fsegurac/design_emb/FPGA.png

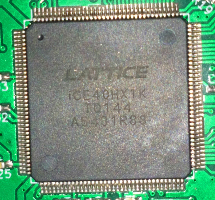
FPGA.png
