fsegurac/design_emb/STM.png

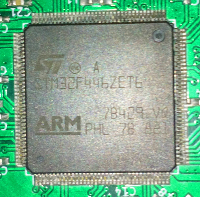
STM.png
