fsegurac/design_emb/stm32f446ze/README.txt

##Herramientas necesarias:

sudo apt-get install gcc-arm-none-eabi
sudo apt-get install libnewlib-arm-none-eabi

NOTA: los archivos principales fueron generados con ayuda del software STM32CubeMx
