fsegurac/design_emb/links.txt

MANUAL KICAD: http://docs.kicad-pcb.org/4.0.7/es/getting_started_in_kicad.html
STM32F446ZE: https://www.st.com/en/microcontrollers/stm32f446ze.html#samplebuy-scroll
SR3.3.TCT: https://www.semtech.com/uploads/documents/sr3.3.pdf
SR2.8.TCT: https://co.mouser.com/datasheet/2/761/sr2_8-1277654.pdf
V. REGULATOR: https://www.digikey.com/products/en/integrated-circuits-ics/pmic-voltage-regulators-linear/699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
https://www.digikey.com/product-detail/en/texas-instruments/TLV1117LV33DCYR/296-28778-2-ND/2666508

COMANDOS GIT:
git init
git add README.md
git commit -m "comentario"
git remote add origin https://github.com/fsegurac/design_emb.git
git push -u origin master
