fsegurac/design_emb/Arachne.png

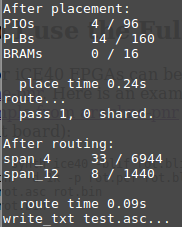
Arachne.png
