fsegurac/design_emb/Board.png

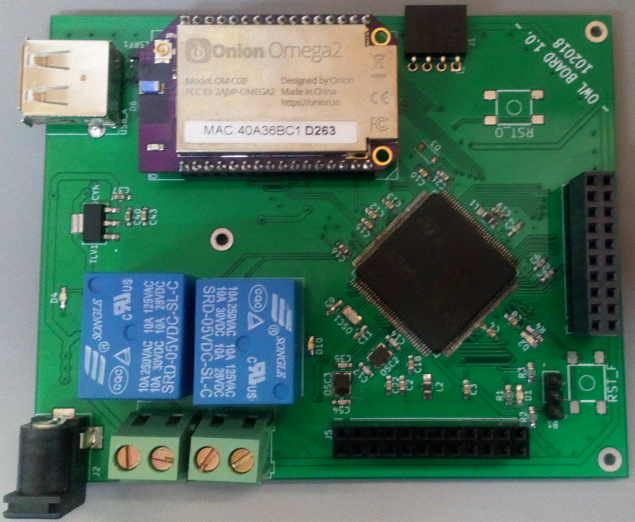
Board.png
