fsegurac/design_emb/JTAGcnfig1.png

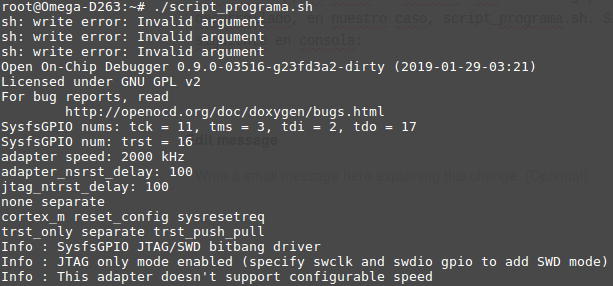
JTAGcnfig1.png
