fsegurac/design_emb/JTAGcnfig2.png

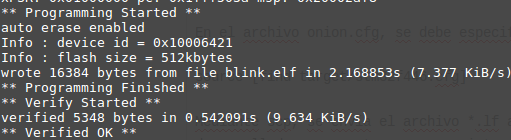
JTAGcnfig2.png
