fsegurac/design_emb/JTAGpins.png

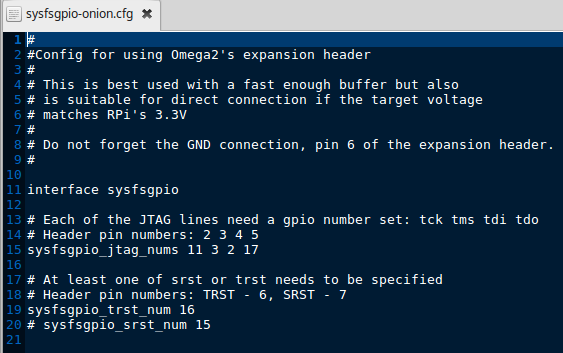
JTAGpins.png
