fsegurac/design_emb/onion/D263.png

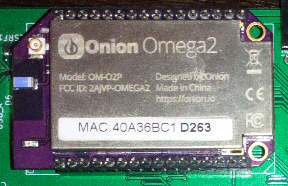
onion/D263.png
