fsegurac/design_emb/onion/OmegaDone.png

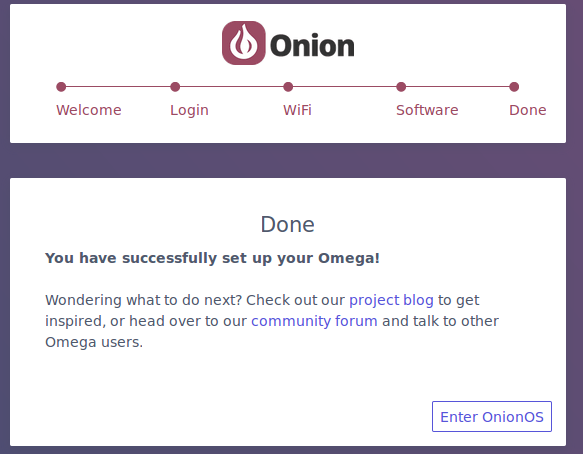
onion/OmegaDone.png
