fsegurac/design_emb/onion/OnionLogin.png

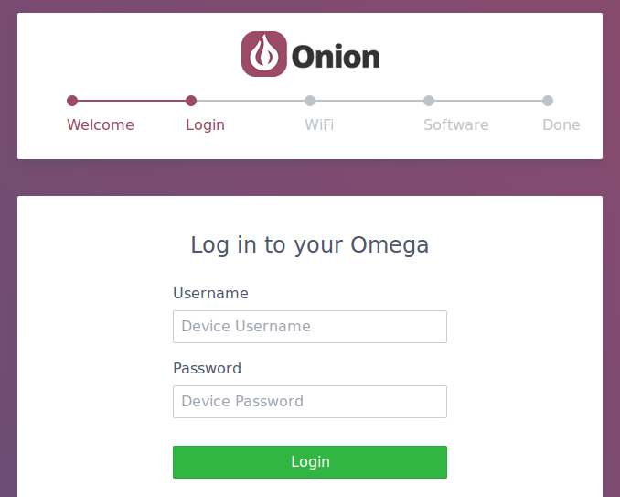
onion/OnionLogin.png
