fsegurac/design_emb/onion/OnionMenu.png

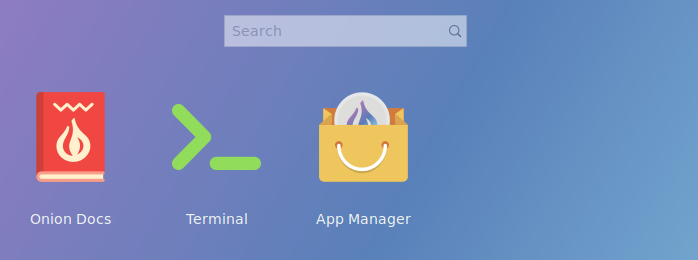
onion/OnionMenu.png
