fsegurac/design_emb/onion/OnionSSH.png

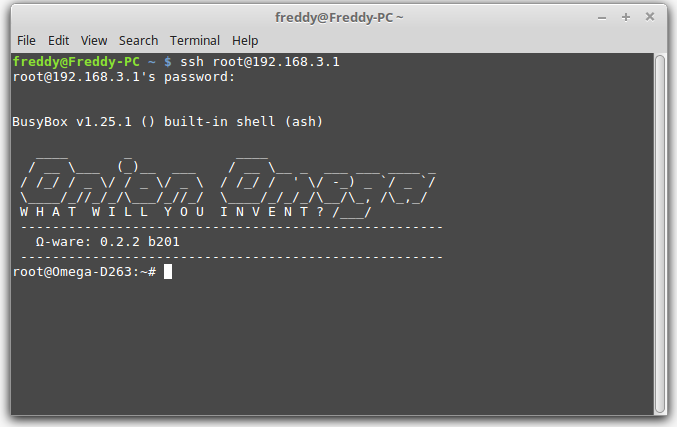
onion/OnionSSH.png
