fsegurac/design_emb/onion/OnionToUpdate.png

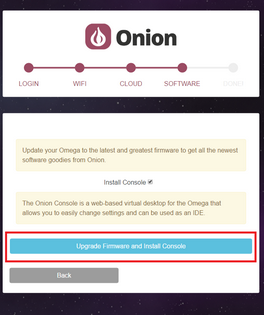
onion/OnionToUpdate.png
