fsegurac/design_emb/onion/WirelessNetwork.png

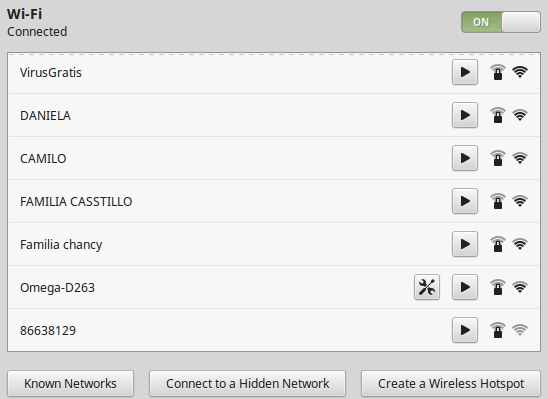
onion/WirelessNetwork.png
