fsegurac/design_emb/(list of files, cad)

Other CAD files:
kicad/modules/kicad-footprints-master/Sources/Package_SON/X2SON-4_1x1mm_P0.65mm.fcstd
kicad/modules/kicad-footprints-master/Sources/Package_TO_SOT_THT/sod-70_P5.08mm.fcstd
kicad/modules/kicad-footprints-master/Sources/Package_TO_SOT_THT/sod-70.fcstd
