fsegurac/design_emb/(list of files, drawings)

Other design files:
kicad/design_emb.dsn
