fsegurac/design_emb/kicad/design_emb.kicad_pcb

## KiCad design kicad/design_emb.kicad_pcb (2019-03-18)

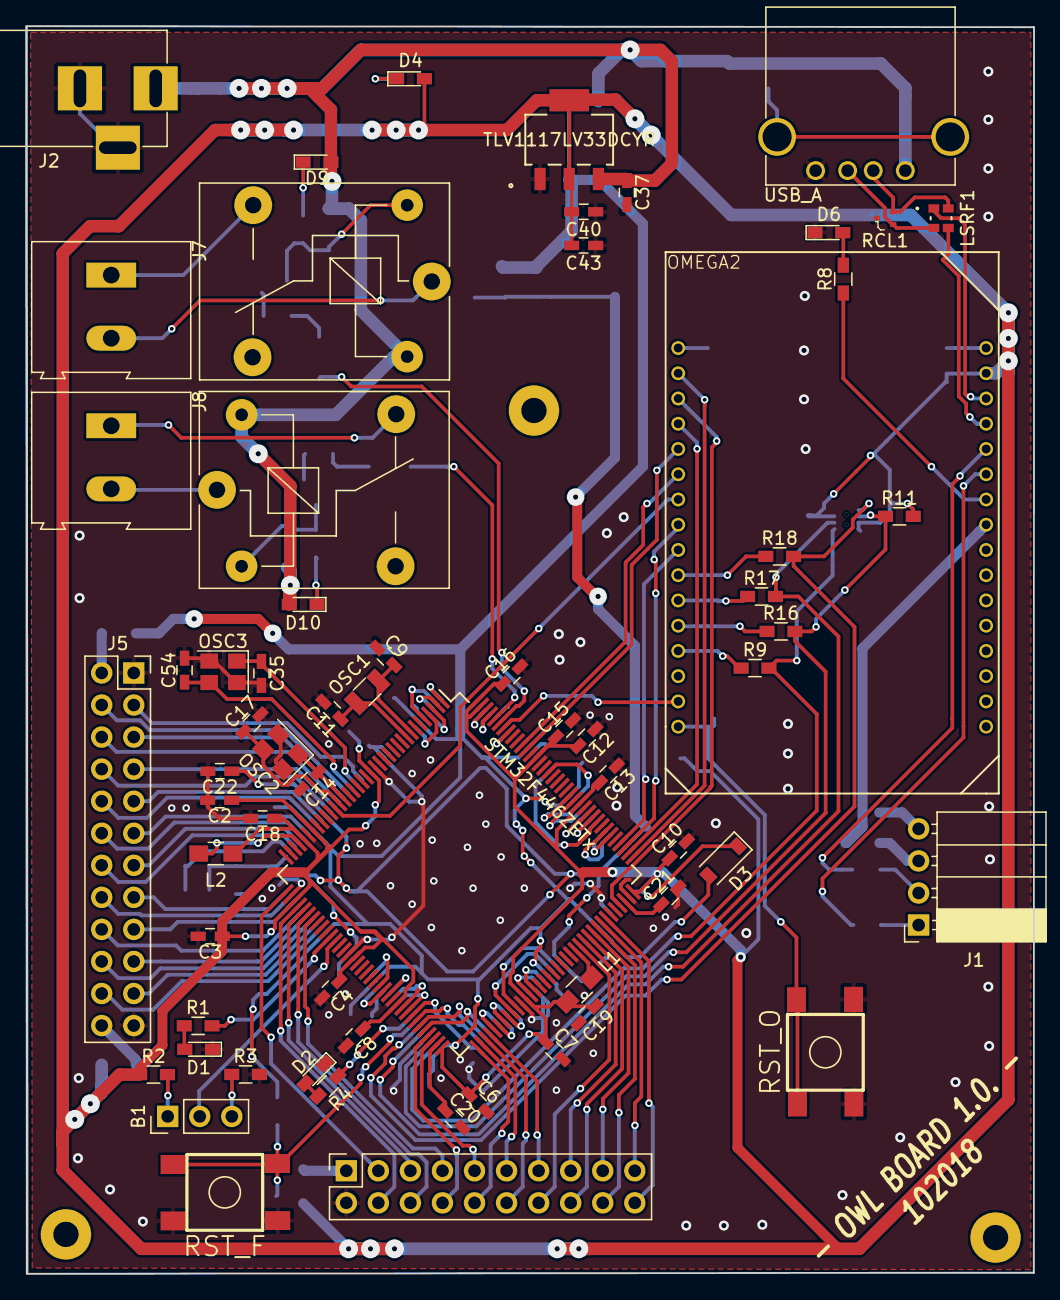
[picture p15: board design_emb.kicad_pcb from above]

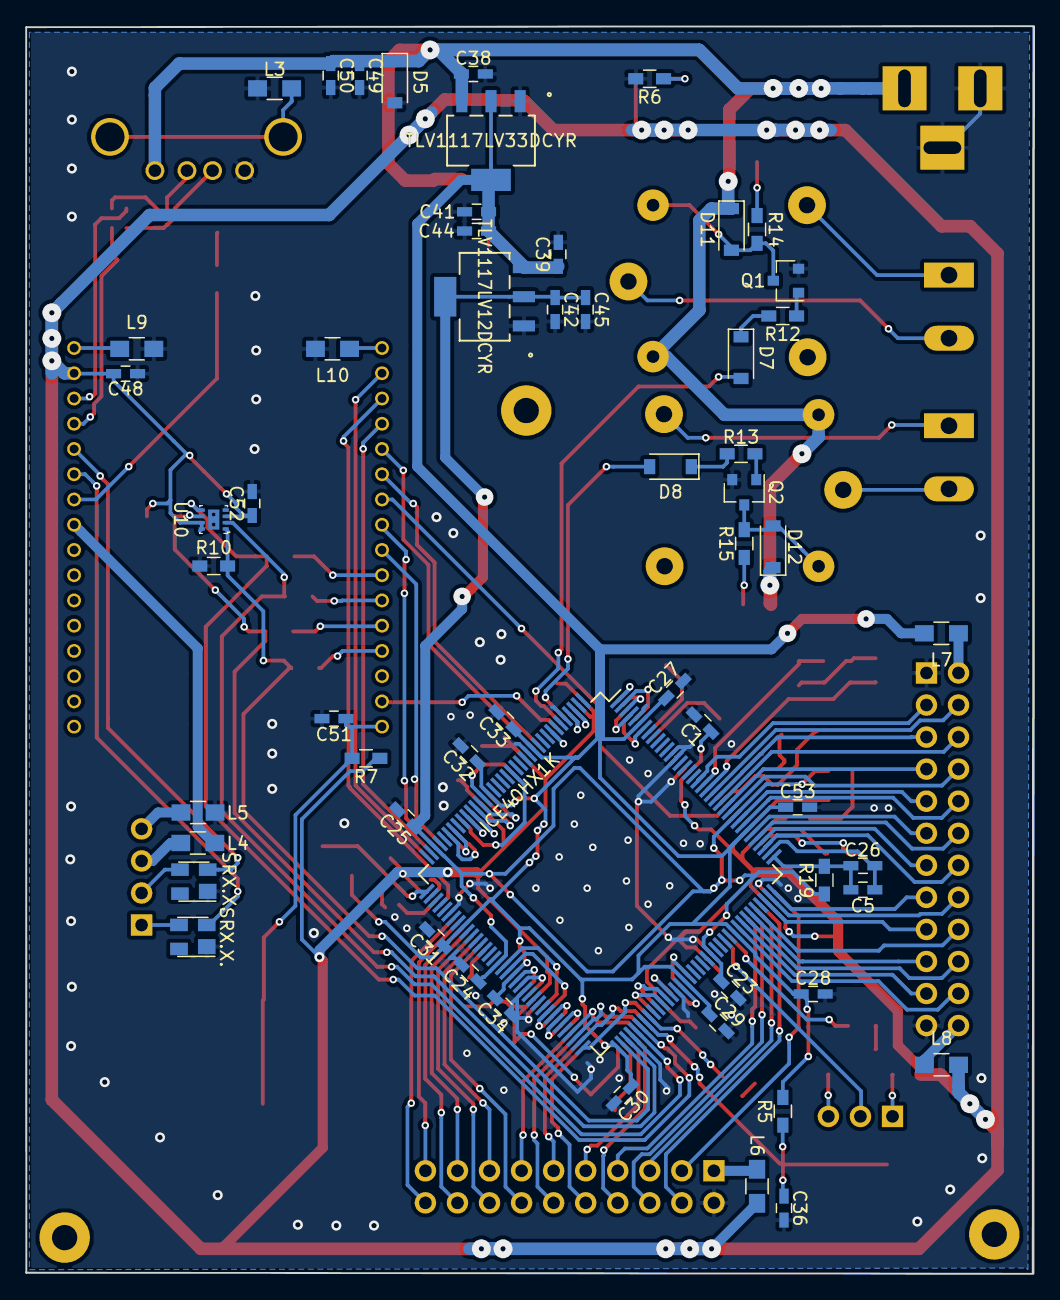
[picture p16: board design_emb.kicad_pcb from below]

Board: 2 copper layers, 79.8 x 98.9 mm, 121 parts (56 on the bottom side), 149 nets.

Parts:
B1: Conn_01x03; Pin_Header_Straight_1x03_Pitch2.54mm
C1, C2, C3, C4, C6, C7, C8, C10, C12, C13, C15, C18, C22, C23, C24, C25, C26, C27, C28, C29, C30, C31, C32, C33, C34, C36, C48, C51, C52, C53: 100nF; C_0603_HandSoldering
C5: 10uF; C_0603_HandSoldering
C9, C11: 9pF; C_0603_HandSoldering
C14, C17, C35, C54: 10pF; C_0603_HandSoldering
C16: 4.7uF; C_0603_HandSoldering
C19, C37, C38, C39, C40, C41, C42: 1uF; C_0603_HandSoldering
C20, C21: 2.2uF; C_0603_HandSoldering
C43, C44, C45, C50: 0.1uF; C_0603_HandSoldering
C49: 33uF; C_0603_HandSoldering
D1: LED_PRB; LED_0603_HandSoldering
D2: LED; LED_0603_HandSoldering
D3: 1N5817; D_SOD-123
D4: LED_ON; LED_0603_HandSoldering
D5: D_Scho; D_SOD-123
D6: LED_PROBE; LED_0603_HandSoldering
D7, D8: D_Schottky; D_SOD-123
D9, D10: LED_REL_ON; LED_0603_HandSoldering
D11, D12: D; D_SOD-123
ICE40HX1K: ICE40HX1K; LQFP-144_20x20mm_Pitch0.5mm
J1: Conn_01x04; PinSocket_1x04_P2.54mm_Horizontal
J2: Barrel_Jack; BARREL_JACK
J5: Conn_02x12_Counter_Clockwise; Socket_Strip_Straight_2x12_Pitch2.54mm
J6: Conn_02x10_Counter_Clockwise; Socket_Strip_Straight_2x10_Pitch2.54mm
J7, J8: Screw_Terminal_01x02; TerminalBlock_Altech_AK300-2_P5.00mm
K1, K2: SANYOU_SRD_Form_C; Relay_SPDT_SANYOU_SRD_Series_Form_C
L1, L2: INDUCTOR; L_0805_HandSoldering
L3, L4, L5, L6, L7, L8, L9, L10: L; L_0805_HandSoldering
LSRF1: SRF2012-900YA
OMEGA2: OMEGA2; ONION2
OSC1: 32,768K; Crystal_SMD_3215-2Pin_3.2x1.5mm
OSC2, OSC3: 12MHz; Crystal_SMD_Abracon_ABM8G-4pin_3.2x2.5mm
Q1, Q2: MMBT3904; SOT-23
R1, R4, R6, R8: 1k; R_0603_HandSoldering
R2, R3, R5, R7: 10k; R_0603_HandSoldering
R9, R16, R17, R18, R19: 100; R_0603_HandSoldering
R10, R11: 4.7k; R_0603_HandSoldering
R12, R13: 5,1K; R_0603_HandSoldering
R14, R15: 2,2K; R_0603_HandSoldering
RCL1: RCLAMP0502B; SOT-523
RST_F: SW_Push; TACTILE_SWITCH_6mm
RST_O: SW_Push; TACTILE_SWITCH_6mm
SRX.X., SRX.X.#2: SRX.X.TCT; SOT-143
STM32F446ZETx: STM32F446ZETx; LQFP-144_20x20mm_Pitch0.5mm
U5, U6: TLV1117LV33DCYR
U7: TLV1117LV12DCYR; TLV1117LV33DCYR
U10: S25FL116KOXNFIQ-11; WSON-8_2x2mm
USB_A: USB_A

Connections:
+5VA: C37.1, C38.1, C49.1, C50.1, D5.1, D9.2, D10.2, D11.1, D12.1, J2.1, K1.5, K2.5, U5.3, U6.3, USB_A.1
/3V3_O: L4.2, OMEGA2.25
/RX_OUT: J1.1, SRX.X..3
/SERIAL_RX: OMEGA2.27, SRX.X..2
/SERIAL_TX: OMEGA2.28, SRX.X.#2.2
/Sheet1/BOOT0: OMEGA2.15, STM32F446ZETx.138
/Sheet1/BOOT1: B1.2, STM32F446ZETx.48
/Sheet1/CTRL0: ICE40HX1K.137, STM32F446ZETx.137
/Sheet1/CTRL1: ICE40HX1K.128, STM32F446ZETx.117
/Sheet1/CTRL2: ICE40HX1K.118, STM32F446ZETx.118
/Sheet1/CTRL3: ICE40HX1K.119, STM32F446ZETx.119
/Sheet1/CTRL4: ICE40HX1K.120, STM32F446ZETx.122
/Sheet1/CTRL5: ICE40HX1K.121, STM32F446ZETx.123
/Sheet1/FMCA16: ICE40HX1K.81, STM32F446ZETx.80
/Sheet1/FMCA17: ICE40HX1K.90, STM32F446ZETx.81
/Sheet1/FMCA18: ICE40HX1K.91, STM32F446ZETx.82
/Sheet1/FMCA19: ICE40HX1K.3, STM32F446ZETx.2
/Sheet1/FMCA20: ICE40HX1K.4, STM32F446ZETx.3
/Sheet1/FMCA21: ICE40HX1K.7, STM32F446ZETx.4
/Sheet1/FMCA22: ICE40HX1K.2, STM32F446ZETx.5
/Sheet1/FMCA23: ICE40HX1K.1, STM32F446ZETx.1
/Sheet1/FMCA24: ICE40HX1K.122, STM32F446ZETx.128
/Sheet1/FMCAD0: ICE40HX1K.87, STM32F446ZETx.85
/Sheet1/FMCAD1: ICE40HX1K.88, STM32F446ZETx.86
/Sheet1/FMCAD2: ICE40HX1K.115, STM32F446ZETx.114
/Sheet1/FMCAD3: ICE40HX1K.114, STM32F446ZETx.115
/Sheet1/FMCAD4: ICE40HX1K.56, STM32F446ZETx.58
/Sheet1/FMCAD5: ICE40HX1K.58, STM32F446ZETx.59
/Sheet1/FMCAD6: ICE40HX1K.60, STM32F446ZETx.60
/Sheet1/FMCAD7: ICE40HX1K.61, STM32F446ZETx.63
/Sheet1/FMCAD8: ICE40HX1K.62, STM32F446ZETx.64
/Sheet1/FMCAD9: ICE40HX1K.73, STM32F446ZETx.65
/Sheet1/FMCAD10: ICE40HX1K.74, STM32F446ZETx.66
/Sheet1/FMCAD11: ICE40HX1K.75, STM32F446ZETx.67
/Sheet1/FMCAD12: ICE40HX1K.76, STM32F446ZETx.68
/Sheet1/FMCAD13: ICE40HX1K.78, STM32F446ZETx.77
/Sheet1/FMCAD14: ICE40HX1K.79, STM32F446ZETx.78
/Sheet1/FMCAD15: ICE40HX1K.80, STM32F446ZETx.79
/Sheet1/FMCNBL0: ICE40HX1K.141, STM32F446ZETx.141
/Sheet1/FMCNBL1: ICE40HX1K.142, STM32F446ZETx.142
/Sheet1/JTAG0: OMEGA2.2, STM32F446ZETx.109
/Sheet1/JTAG1: OMEGA2.3, STM32F446ZETx.105
/Sheet1/JTAG2: OMEGA2.4, STM32F446ZETx.110
/Sheet1/JTAG3: OMEGA2.5, STM32F446ZETx.133
/Sheet1/JTAG4: OMEGA2.6, STM32F446ZETx.134
/Sheet1/OSC32_IN: C9.1, OSC1.1, STM32F446ZETx.8
/Sheet1/OSC32_OUT: C11.1, OSC1.2, STM32F446ZETx.9
/Sheet1/OSC_IN: C14.1, OSC2.1, STM32F446ZETx.23
/Sheet1/OSC_OUT: C17.1, OSC2.3, STM32F446ZETx.24
/Sheet1/PROBE: R1.2, STM32F446ZETx.47
/Sheet1/UART4_RX: OMEGA2.9, STM32F446ZETx.112
/Sheet1/UART4_TX: OMEGA2.8, STM32F446ZETx.111
/Sheet1/USR1: J6.3, STM32F446ZETx.37
/Sheet1/USR2: J6.4, STM32F446ZETx.40
/Sheet1/USR3: J6.5, STM32F446ZETx.41
/Sheet1/USR4: J6.6, STM32F446ZETx.42
/Sheet1/USR5: J6.7, STM32F446ZETx.43
/Sheet1/USR6: J6.8, STM32F446ZETx.69
/Sheet1/USR7: J6.9, STM32F446ZETx.70
/Sheet1/USR8: J6.10, STM32F446ZETx.73
/Sheet1/USR9: J6.11, STM32F446ZETx.74
/Sheet1/USR10: J6.12, STM32F446ZETx.75
/Sheet1/USR11: J6.13, STM32F446ZETx.76
/Sheet1/USR12: J6.14, STM32F446ZETx.96
/Sheet1/USR13: J6.15, STM32F446ZETx.97
/Sheet1/USR14: J6.16, STM32F446ZETx.98
/Sheet1/USR15: J6.17, STM32F446ZETx.99
/Sheet1/USR16: J6.18, STM32F446ZETx.100
/Sheet1/USR17: J6.19, STM32F446ZETx.101
/Sheet1/USR18: J6.20, STM32F446ZETx.102
/Sheet1/VCAP1: C20.1, STM32F446ZETx.71
/Sheet1/VCAP2: C21.1, STM32F446ZETx.106
/Sheet1/VDDA: L2.2, STM32F446ZETx.33
/Sheet1/VDDUSB: L1.2, STM32F446ZETx.95
/Sheet2/JNRST: OMEGA2.7, STM32F446ZETx.25
/Sheet2/PROBE: OMEGA2.26, R8.1
/Sheet2/RESET: C51.1, OMEGA2.16, R7.2, RST_O.1
/Sheet2/SPI0: ICE40HX1K.71, R9.2, R10.2, U10.1
/Sheet2/SPI1: ICE40HX1K.70, R11.1, R16.2, U10.6
/Sheet2/SPI2: ICE40HX1K.68, R17.2, U10.2
/Sheet2/SPI3: ICE40HX1K.67, R18.2, U10.5
/Sheet2/USB+: LSRF1.1, OMEGA2.30
/Sheet2/USB-: LSRF1.3, OMEGA2.29
/Sheet4/+1V2_FPGA: C22.1, C23.1, C24.1, C25.1, C42.1, C45.1, ICE40HX1K.27, ICE40HX1K.51, ICE40HX1K.92, ICE40HX1K.111, R19.2, U7.2, U7.4
/Sheet4/+3V3: C1.1, C2.1, C3.1, C4.1, C6.1, C7.1, C8.1, C10.1, C12.1, C13.1, C15.1, C16.1, C18.1, C19.1, C40.1, C43.1, C48.1, C52.1, D4.2, L1.1, L2.1, L6.2, L8.2, OMEGA2.31, R2.1, R7.1, R11.2, STM32F446ZETx.17, STM32F446ZETx.30, STM32F446ZETx.32, STM32F446ZETx.39, STM32F446ZETx.52, STM32F446ZETx.62, STM32F446ZETx.72, STM32F446ZETx.84, STM32F446ZETx.108, STM32F446ZETx.121, STM32F446ZETx.131, STM32F446ZETx.143, STM32F446ZETx.144, U5.2, U5.4, U10.3, U10.7, U10.8
/Sheet4/+3V3_FPGA: C27.1, C28.1, C29.1, C30.1, C31.1, C32.1, C33.1, C34.1, C39.1, C41.1, C44.1, C53.1, D3.2, ICE40HX1K.6, ICE40HX1K.30, ICE40HX1K.46, ICE40HX1K.57, ICE40HX1K.72, ICE40HX1K.89, ICE40HX1K.100, ICE40HX1K.123, ICE40HX1K.133, L7.2, R5.2, U6.2, U6.4, U7.3
/Sheet5/IN_REL1: D7.2, STM32F446ZETx.139
/Sheet5/IN_REL2: D8.2, STM32F446ZETx.140
/TX_IN: J1.2, SRX.X.#2.3
/sheet3/CRESET_B: C36.1, ICE40HX1K.66, R5.1, RST_F.1
/sheet3/GPIO0: ICE40HX1K.19, J5.3
/sheet3/GPIO1: ICE40HX1K.22, J5.4
/sheet3/GPIO2: ICE40HX1K.23, J5.5
/sheet3/GPIO3: ICE40HX1K.24, J5.6
/sheet3/GPIO4: ICE40HX1K.25, J5.7
/sheet3/GPIO5: ICE40HX1K.26, J5.8
/sheet3/GPIO6: ICE40HX1K.28, J5.9
/sheet3/GPIO7: ICE40HX1K.29, J5.10
/sheet3/GPIO8: ICE40HX1K.31, J5.11
/sheet3/GPIO9: ICE40HX1K.32, J5.12
/sheet3/GPIO10: ICE40HX1K.33, J5.13
/sheet3/GPIO11: ICE40HX1K.34, J5.14
/sheet3/GPIO12: ICE40HX1K.37, J5.15
/sheet3/GPIO13: ICE40HX1K.38, J5.16
/sheet3/GPIO14: ICE40HX1K.39, J5.17
/sheet3/GPIO15: ICE40HX1K.41, J5.18
/sheet3/GPIO16: ICE40HX1K.42, J5.19
/sheet3/GPIO17: ICE40HX1K.43, J5.20
/sheet3/GPIO18: ICE40HX1K.44, J5.21
/sheet3/GPIO19: ICE40HX1K.45, J5.22
/sheet3/OSC_IN: C35.1, ICE40HX1K.20, OSC3.1
/sheet3/OSC_OUT: C54.1, ICE40HX1K.21, OSC3.3
/sheet3/PLLGND: C5.2, C26.2, ICE40HX1K.35
/sheet3/VCCPLL: C5.1, C26.1, ICE40HX1K.36, R19.1
GND: C1.2, C2.2, C3.2, C4.2, C6.2, C7.2, C8.2, C9.2, C10.2, C11.2, C12.2, C13.2, C14.2, C15.2, C16.2, C17.2, C18.2, C19.2, C20.2, C21.2, C22.2, C23.2, C24.2, C25.2, C27.2, C28.2, C29.2, C30.2, C31.2, C32.2, C33.2, C34.2, C35.2, C36.2, C37.2, C38.2, C39.2, C40.2, C41.2, C42.2, C43.2, C44.2, C45.2, C48.2, C49.2, C50.2, C51.2, C52.2, C53.2, C54.2, D1.1, D2.1, D5.2, D6.1, ICE40HX1K.5, ICE40HX1K.13, ICE40HX1K.14, ICE40HX1K.59, ICE40HX1K.69, ICE40HX1K.86, ICE40HX1K.103, ICE40HX1K.132, ICE40HX1K.140, J2.2, J2.3, J5.1, J5.23, J6.2, L3.2, L5.2, L9.2, L10.2, OSC2.2, OSC2.4, OSC3.2, OSC3.4, Q1.2, Q2.2, R3.2, R6.2, R10.1, RCL1.3, RST_F.2, RST_O.2, SRX.X..1, SRX.X.#2.1, STM32F446ZETx.16, STM32F446ZETx.31, STM32F446ZETx.38, STM32F446ZETx.51, STM32F446ZETx.61, STM32F446ZETx.83, STM32F446ZETx.94, STM32F446ZETx.107, STM32F446ZETx.120, STM32F446ZETx.130, U5.1, U6.1, U7.1, U10.4, USB_A.4
unnamed: D1.2, R1.1
unnamed: D2.2, R4.2
unnamed: D3.1, ICE40HX1K.108
unnamed: D4.1, R6.1
unnamed: D6.2, R8.2
unnamed: D7.1, R12.2
unnamed: D8.1, R13.2
unnamed: D9.1, R14.1
unnamed: D10.1, R15.1
unnamed: D11.2, K1.2, Q1.3, R14.2
unnamed: D12.2, K2.2, Q2.3, R15.2
unnamed: J1.3, L4.1
unnamed: J1.4, L5.1
unnamed: LSRF1.4, RCL1.2, USB_A.2
unnamed: LSRF1.2, RCL1.1, USB_A.3
unnamed: L3.1, USB_A.5
unnamed: B1.1, R2.2
unnamed: B1.3, R3.1
unnamed: J5.2, L7.1
unnamed: J5.24, L8.1
unnamed: J6.1, L6.1
unnamed: J7.1, K1.3
unnamed: J7.2, K1.1
unnamed: J8.1, K2.4
unnamed: J8.2, K2.1
unnamed: L9.1, OMEGA2.32
unnamed: L10.1, OMEGA2.1
unnamed: OMEGA2.10, R18.1
unnamed: OMEGA2.11, R17.1
unnamed: OMEGA2.12, R16.1
unnamed: OMEGA2.13, R9.1
unnamed: Q1.1, R12.1
unnamed: Q2.1, R13.1
unnamed: ICE40HX1K.65, R4.1
