fsegurac/design_emb/onion/OnionSetup.png

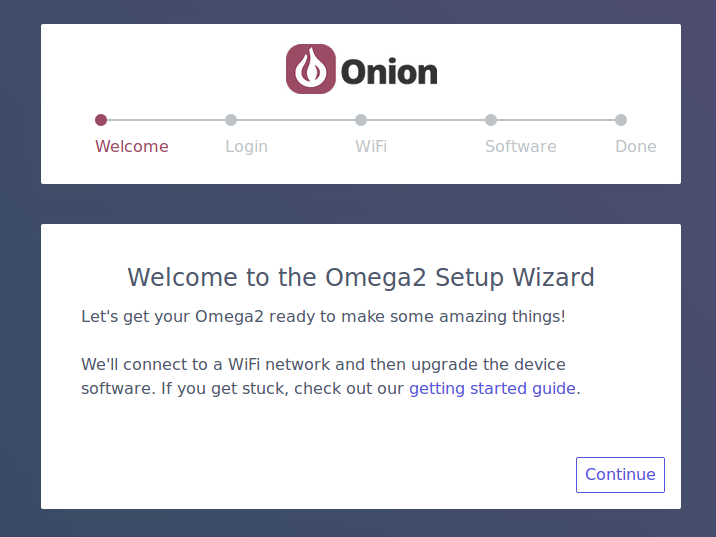
onion/OnionSetup.png
