fsegurac/design_emb/stm32f446ze/blink/blink.ioc

Mcu.UserName=STM32F446ZETx
PA13.Signal=SYS_JTMS-SWDIO
PA14.Signal=SYS_JTCK-SWCLK
PA15.Signal=SYS_JTDI
PB1.Signal=GPIO_Output
PB3.Signal=SYS_JTDO-SWO
PB4.Signal=SYS_JTRST
PC14-OSC32_IN.Signal=RCC_OSC32_IN
PC15-OSC32_OUT.Signal=RCC_OSC32_OUT
PH0-OSC_IN.Signal=RCC_OSC_IN
PH1-OSC_OUT.Signal=RCC_OSC_OUT
