fsegurac/design_emb/(commit log)

2018-08-24 creacion bus y libreria
    [design_emb.sch, hoja1.sch]
2018-08-27 libreria kicad-4
2018-08-27 actualización kicad
2018-08-27 creacion bus FMC
    [design_emb.sch, hoja1.sch]
2018-08-28 creacion buses y alimentacion .sch
    [hoja1.sch]
2018-08-29 modificaciones stm32 y adición de Omega-2
    [OMEGA2sch.sch, STM32F446ZETx.sch, design_emb.sch]
2018-08-30 comunicación serial usuario
    [STM32F446ZETx.sch]
2018-08-30 osciladores stm32
    [STM32F446ZETx.sch, iCE40144-pinTQFPMigration.xlsx]
2018-09-01 Borrado de archivos .bck
2018-09-02 creacion simbolo fpga (3 bancos)
    [OMEGA2sch.sch, STM32F446ZETx.sch, design_emb.sch, fpga.sch, iCE40144-pinTQFPMigration.xlsx]
2018-09-02 creación completa símbolo fpga ice40hx1k
    [fpga.sch]
2018-09-04 capacitores desacople stm32
    [STM32F446ZETx.sch]
2018-09-04 reconfiguracion capacitores de desacople
    [STM32F446ZETx.sch]
2018-09-04 link V. regulator
2018-09-11 regulador 3v3
    [OMEGA2sch.sch, STM32F446ZETx.sch, design_emb.sch, fpga.sch, power.sch]
2018-09-12 reguladores y conexión a stm32
    [STM32F446ZETx.sch, design_emb.sch, power.sch]
2018-09-12 comunicación omega2 y stm32
    [OMEGA2sch.sch, STM32F446ZETx.sch, design_emb.sch]
2018-09-12 usb omega2
    [OMEGA2sch.sch, fpga.sch, power.sch]
2018-09-13 leds de prueba
    [OMEGA2sch.sch, STM32F446ZETx.sch, power.sch]
2018-09-19 footprints resistencias y condensadores
    [OMEGA2sch.sch, STM32F446ZETx.sch, design_emb.sch, fpga.sch, power.sch]
2018-09-24 footprints y JTAG
    [OMEGA2sch.sch, STM32F446ZETx.sch, design_emb.sch, fpga.sch, power.sch]
2018-09-26 arreglo huella fpga
    [iCE40144-pinTQFPMigration.xlsx]
2018-09-26 boot1 jack
    [STM32F446ZETx.sch]
2018-09-27 perifericos stm32
    [OMEGA2sch.sch, STM32F446ZETx.sch, design_emb.sch, fpga.sch, perf_stm.sch, power.sch]
2018-10-02 corrección footprints
    [OMEGA2sch.sch, STM32F446ZETx.sch, fpga.sch, perf_stm.sch, power.sch]
2018-10-03 buses JTAG, FMC_AD y CTRL
    [OMEGA2sch.sch, STM32F446ZETx.sch, design_emb.sch, fpga.sch]
2018-10-04 bus SPI, FMC_A Y FMC_NBL
    [OMEGA2sch.sch, STM32F446ZETx.sch, design_emb.kicad_pcb, design_emb.sch, fpga.sch, perf_stm.sch, power.sch]
2018-10-04 arreglo pines FPGA compatibilidad STM32
    [OMEGA2sch.sch, STM32F446ZETx.sch, design_emb.kicad_pcb, design_emb.sch, fpga.sch]
2018-10-05 footprint sw_push
    [_saved_OMEGA2sch.sch, _saved_perf_stm.sch, design_emb.kicad_pcb]
2018-10-11 plano de tierra y modificación de señales
    [OMEGA2sch.sch, STM32F446ZETx.sch, design_emb.kicad_pcb, design_emb.sch, fpga.sch, power.sch]
2018-10-16 modificación alimentación PLL fpga
    [design_emb.kicad_pcb, fpga.sch]
2018-10-18 soportes mecánicos y osc fpga
    [design_emb.kicad_pcb, fpga.sch]
2018-10-19 correcciones silk
    [design_emb.kicad_pcb]
2018-10-19 cambio osc1 stm32
    [STM32F446ZETx.sch, design_emb.kicad_pcb]
2018-10-19 datasheet diodos schottky
    [perf_stm.sch]
2018-10-19 corrección errores DRC
    [design_emb.kicad_pcb]
2018-10-20 vías de GND
    [design_emb.kicad_pcb]
2018-10-20 cambio socket fpga
    [design_emb.kicad_pcb, fpga.sch]
2019-02-14 archivos necesarios en Omega2
    [onion.cfg]
2019-02-14 archivos de programacion stm32f446
    [stm32f4x-probe.cfg, sysfsgpio-onion.cfg]
2019-03-18 correcciones pcb
    [OMEGA2sch.sch, design_emb.kicad_pcb, fpga.sch]
